RPBCACUEAIIBH/SolarTrackerMK1/README.md

Copyright (c) 2019, Tibor Áser Veres

This repository is licensed under a Creative Commons Attribution 4.0 International License.
https://creativecommons.org/licenses/by/4.0

- The MK I circuit was designed for DIY-ers, with off the shelf modules and minimal custom circuit. (MK II will be more professional single board desing.)
- The program still lacks a couple of features, but seems to work fine.
- Instructions on how to set it right coming soon... For now ask on Discord!
