RPBCACUEAIIBH/SolarTrackerMK1/SolarTracker MK I Schematic.pdf

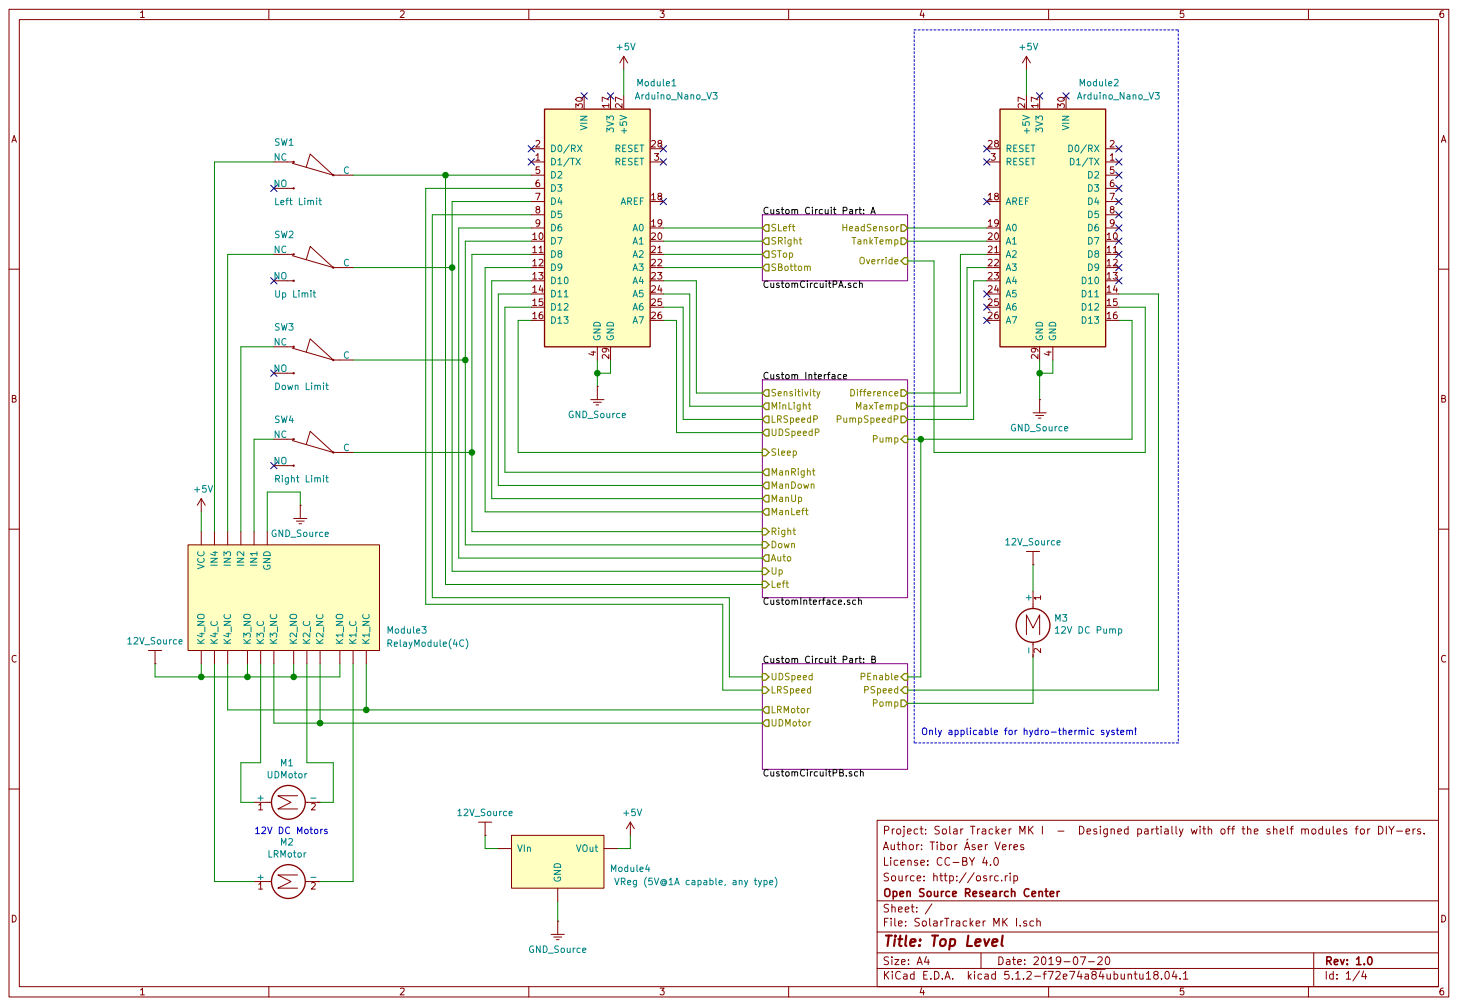
[picture p1: page 1]

4 D2 5 D3 6 D4 7 D5 8 D6 9 Module1 Arduino_Nano_V3 D1/TX 1 D7 10 D8 11 D9 12 D10 13 D11 14 D12 15 D13 16 3V3 17 AREF 18 A0 19 D0/RX 2 A1 20 A2 21 A3 22 A4 23 A5 24 A6 25 A7 26 +5V 27 RESET 28 GND 29 RESET 3 VIN 30 GND

MinLight
LRSpeedP
Left Sleep
ManUp Auto ManLeft ManDown ManRight

License: CC-BY 4.0 Author: Tibor Áser Veres

Source: http://osrc.rip
Id: 1/4 Title: Top Level File: SolarTracker MK I.sch Sheet: / Open Source Research Center

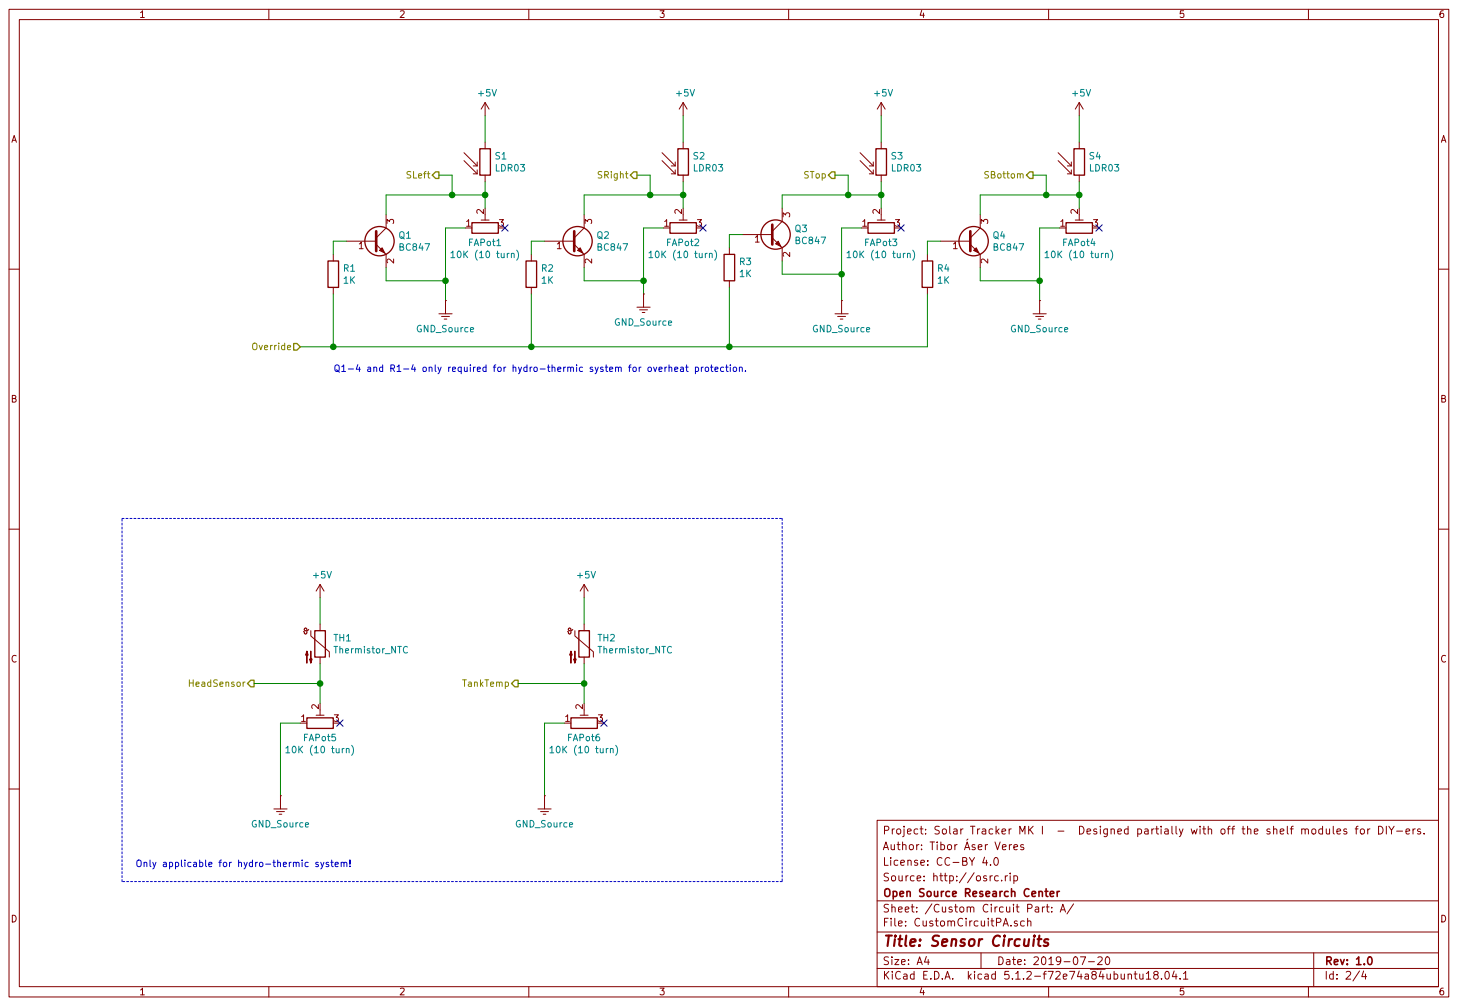
[picture p2: page 2]

2 3 Q2BC847 SLeft SRight STop SBottom

TH1 Thermistor_NTC Only applicable for hydro-thermic system!

License: CC-BY 4.0 Author: Tibor Áser Veres

Source: http://osrc.rip
File: CustomCircuitPA.sch Sheet: /Custom Circuit Part: A/ Open Source Research Center

Id: 2/4 Title: Sensor Circuits

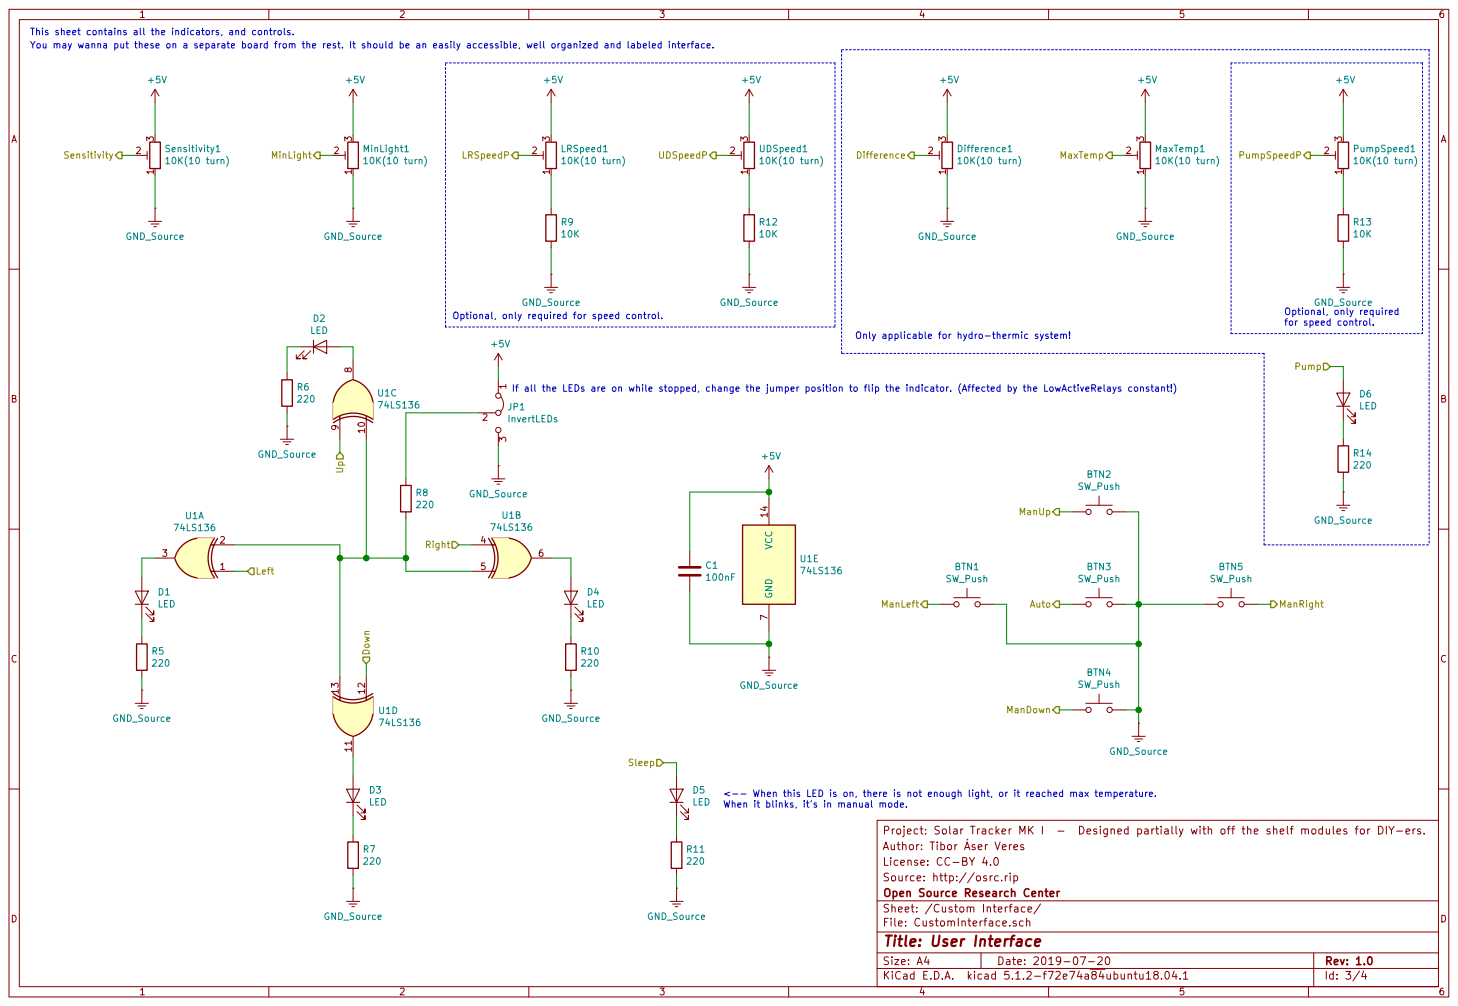
[picture p3: page 3]

Pump This sheet contains all the indicators, and controls. You may wanna put these on a separate board from the rest. It should be an easily accessible, well organized and labeled interface.

License: CC-BY 4.0 Author: Tibor Áser Veres

Source: http://osrc.rip
File: CustomInterface.sch Sheet: /Custom Interface/ Open Source Research Center

Id: 3/4 Title: User Interface

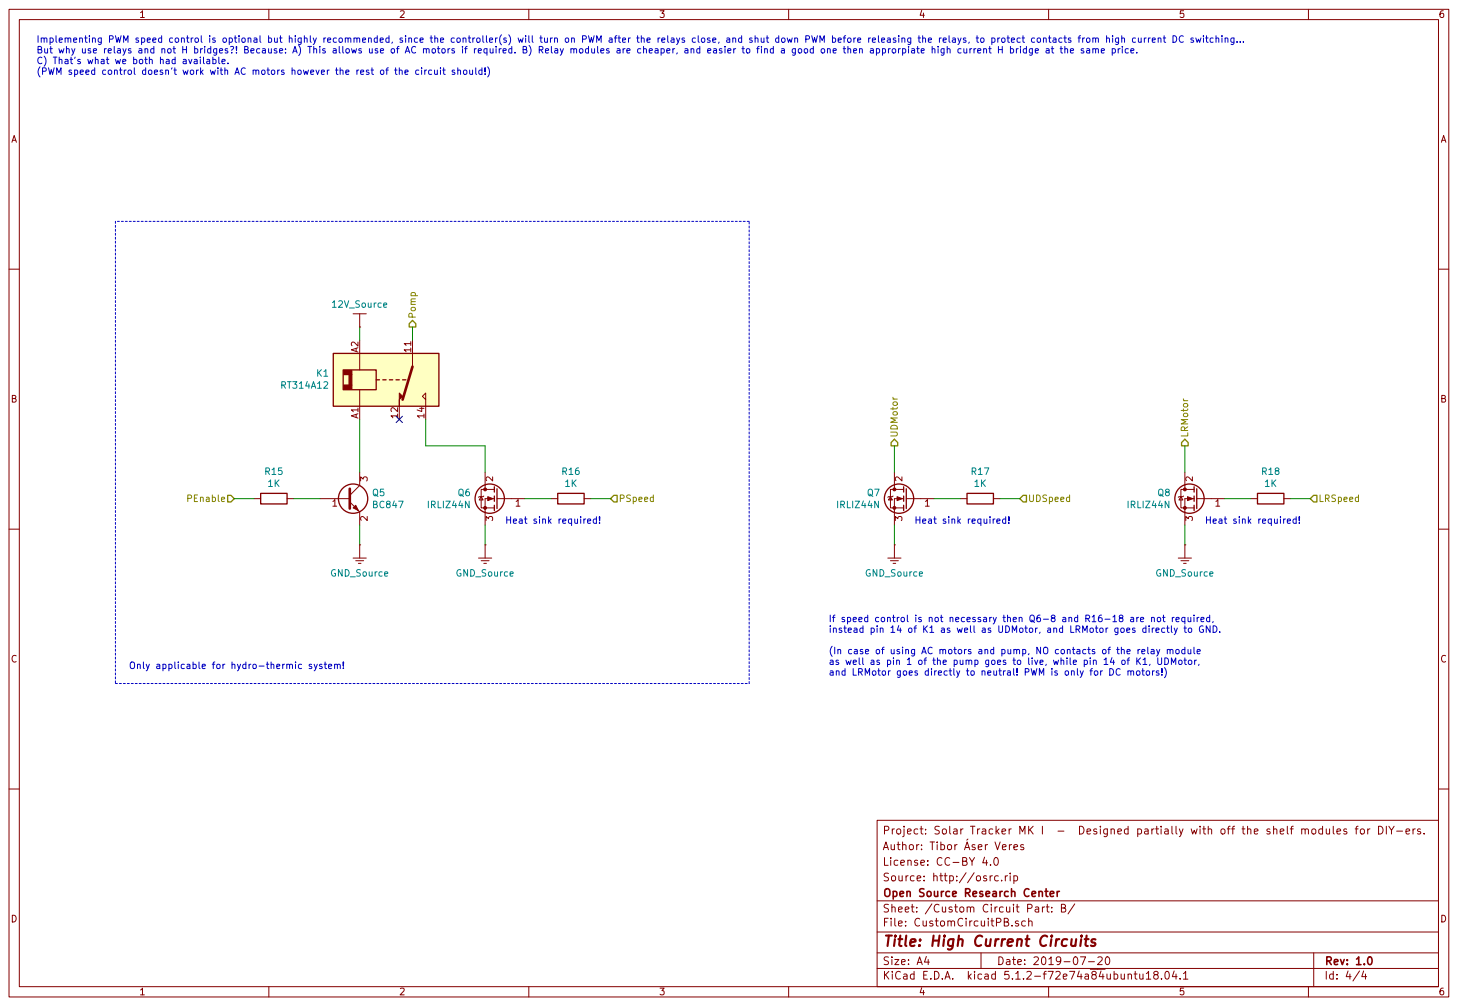
[picture p4: page 4]

Implementing PWM speed control is optional but highly recommended, since the controller(s) will turn on PWM after the relays close, and shut down PWM before releasing the relays, to protect contacts from high current DC switching...
But why use relays and not H bridges?! Because: A) This allows use of AC motors if required. B) Relay modules are cheaper, and easier to find a good one then approrpiate high current H bridge at the same price.
C) That's what we both had available.
(PWM speed control doesn't work with AC motors however the rest of the circuit should!)

If speed control is not necessary then Q6-8 and R16-18 are not required,
instead pin 14 of K1 as well as UDMotor, and LRMotor goes directly to GND.

(In case of using AC motors and pump, NO contacts of the relay module
as well as pin 1 of the pump goes to live, while pin 14 of K1, UDMotor,
and LRMotor goes directly to neutral! PWM is only for DC motors!)

Only applicable for hydro-thermic system!

License: CC-BY 4.0 Author: Tibor Áser Veres

Source: http://osrc.rip
File: CustomCircuitPB.sch Sheet: /Custom Circuit Part: B/ Open Source Research Center

Id: 4/4 Title: High Current Circuits
