RPBCACUEAIIBH/SolarTrackerMK1/KiCADFiles/SolarTracker MK I/CustomCircuitPA.sch

## KiCad design KiCADFiles/SolarTracker MK I/CustomCircuitPA.sch (2019-07-20)

Schematic: CustomCircuitPA.sch

Parts:
FAPot1, FAPot2, FAPot3, FAPot4, FAPot5, FAPot6: 10K (10 turn)
Q1, Q2, Q3, Q4: BC847; SOT-23
R1, R2, R3, R4: 1K
S1, S2, S3, S4: LDR03; R_LDR_10x8.5mm_P7.6mm_Vertical
TH1, TH2: Thermistor_NTC

Notes on the sheet:
Q1-4 and R1-4 only required for hydro-thermic system for overheat protection.
Only applicable for hydro-thermic system!
