RPBCACUEAIIBH/SolarTrackerMK1/KiCADFiles/SolarTracker MK I/CustomCircuitPB.sch

## KiCad design KiCADFiles/SolarTracker MK I/CustomCircuitPB.sch (2019-07-20)

Schematic: CustomCircuitPB.sch

Parts:
K1: RT314A12; Relay_SPDT_Schrack-RT1-16A-FormC_RM5mm
Q5: BC847; SOT-23
Q6, Q7, Q8: IRLIZ44N; TO-220F-3_Vertical
R15, R16, R17, R18: 1K

Notes on the sheet:
Heat sink required!
Only applicable for hydro-thermic system!
Implementing PWM speed control is optional but highly recommended, since the controller(s) will turn on PWM after the relays close, and shut down PWM before releasing the relays, to protect contacts from high current DC switching... But why use relays and not H bridges?! Because: A) This allows use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
If speed control is not necessary then Q6-8 and R16-18 are not required, instead pin 14 of K1 as well as UDMotor, and LRMotor goes directly to GND. (In case of using AC motors and pump, NO contacts of the relay module as well as pin 1 of the pump goes to live, while pin 14 of K1, UDMotor, and LRMot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
