RPBCACUEAIIBH/SolarTrackerMK1/KiCADFiles/SolarTracker MK I/CustomInterface.sch

## KiCad design KiCADFiles/SolarTracker MK I/CustomInterface.sch (2019-07-20)

Schematic: CustomInterface.sch

Parts:
BTN1, BTN2, BTN3, BTN4, BTN5: SW_Push
C1: 100nF
D1, D2, D3, D4, D5, D6: LED
Difference1: 10K(10 turn)
JP1: InvertLEDs
LRSpeed1: 10K(10 turn)
MaxTemp1: 10K(10 turn)
MinLight1: 10K(10 turn)
PumpSpeed1: 10K(10 turn)
R5, R6, R7, R8, R10, R11, R14: 220
R9, R12, R13: 10K
Sensitivity1: 10K(10 turn)
U1: 74LS136
UDSpeed1: 10K(10 turn)

Notes on the sheet:
Only applicable for hydro-thermic system!
If all the LEDs are on while stopped, change the jumper position to flip the indicator. (Affected by the LowActiveRelays constant!)
This sheet contains all the indicators, and controls.
You may wanna put these on a separate board from the rest. It should be an easily accessible, well organized and labeled interface.
<-- When this LED is on, there is not enough light, or it reached max temperature. When it blinks, it's in manual mode.
Optional, only required for speed control.
Optional, only required for speed control.
