RPBCACUEAIIBH/SolarTrackerMK1/KiCADFiles/SolarTracker MK I/SolarTracker MK I.sch

## KiCad design KiCADFiles/SolarTracker MK I/SolarTracker MK I.sch (2019-07-20)

Schematic: SolarTracker MK I.sch

Parts:
M1: UDMotor
M2: LRMotor
M3: 12V DC Pump
Module1, Module2: Arduino_Nano_V3; Arduino_Nano
Module3: RelayModule(4C)
Module4: VReg (5V@1A capable, any type)
SW1: Left Limit
SW2: Up Limit
SW3: Down Limit
SW4: Right Limit

Notes on the sheet:
12V DC Motors
Only applicable for hydro-thermic system!
