RPBCACUEAIIBH/SolarTrackerMK1/(commit log)

2019-03-15 Added 4th sensor on request...
2019-03-16 Potmeters, Buttons, and PWM Speed control added, serial monitoring improved.
2019-04-03 Added support for low active relay module.
2019-04-04 Default relay polarity flipped.
    [SolarTracker.ino]
2019-06-19 Project Version 0.2 - PumpController added.
2019-06-19 Fixed hysteresis, and head overheating, and improved feedback.
    [Debug.ino, Functions.ino, PumpController.ino]
2019-06-19 Reverted return feature to on by default since this can prevent meltdown with the newly added pump controller measuring temperatures...
    [SolarTracker.ino]
2019-07-20 Project Version 0.3 - Final schematic, and KiCAD files added.
    [CustomCircuitPA.sch, CustomCircuitPB.sch, CustomInterface.sch, SolarTracker MK I.sch]
